negrunicusor/Square-Wave-Signal-Generator-SMT-PCB/Layout/layout.jpg

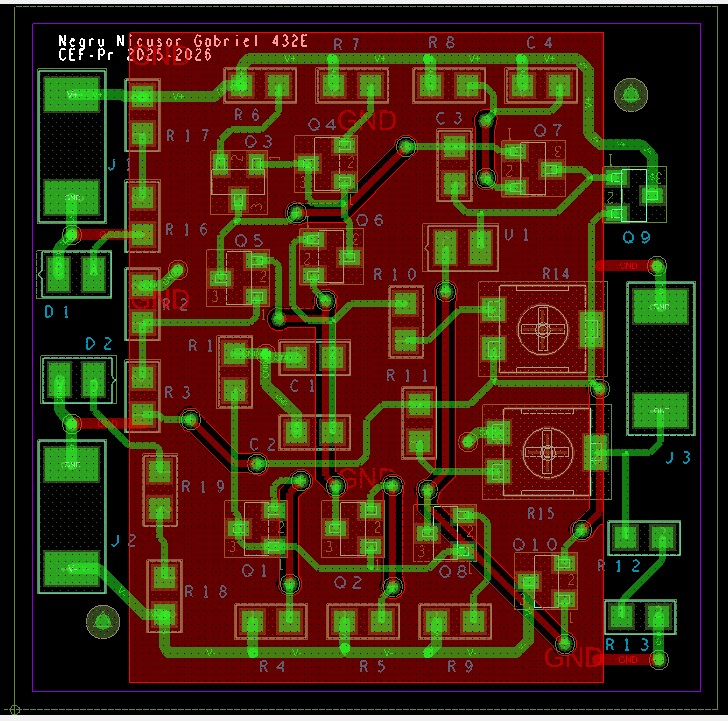
Layout/layout.jpg
