negrunicusor/Square-Wave-Signal-Generator-SMT-PCB/Project_Presentation.pdf

## Circuite Electronice Fundamentale 2 – Proiect (CEF2-Pr)

Student: Negru Nicusor Gabriel Grupa 432E

## Tema: Generator de semnal dreptunghiular

## Date de proiectare

Cerințe electrice:
- Frecvența de oscilație, f0, reglabilă în intervalul 32-64 KHz;
- Factor de umplere: 0.5;
- Sarcina la ieșire, RL
: 16kΩ;
- Valoarea (vârf la vârf) a oscilației la ieșire, V0, reglabilă în intervalul 0-4V;
- Semnalul la ieșire nu are componentă continuă;
- Domeniul temperaturilor de funcționare: 0° - 70°C
- Semnalizarea prezenței tensiunilor de intrare/ieșire cu o diodă de tip LED

Cerințe tehnologice:
- Dimensiunile PCB: 40mm x 40mm;
- Material FR4, dublu strat;
- Originea (punctul de coordonate (0,0)) va fi plasat în colţul din stânga-jos al plăcii de cablaj imprimat)
- Dimensiuni trasee:
- Curent de 1A - 26 mil;
- Curent de sute de mA - 18 mil;
- Semnal - 16 mil;

## Schema bloc

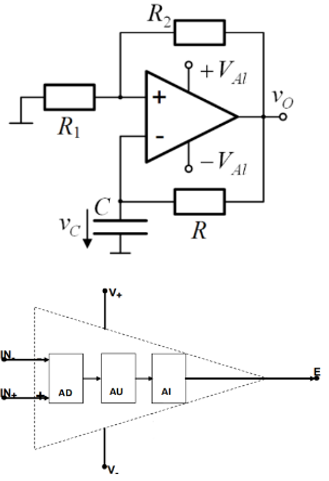
[picture p2: figure]

Oscilatorul de relaxare este constituit dintr-un comparator inversor cu histerezis și o rețea RC pe intrarea inversoare.

Intrarea neinversoare este conectată la un divizorul de tensiune, prin intermediul căruia de aplică o parte din semnalul de la ieșire și prin care se fixează tensiunile de prag de histerezis.

Gruparea RC, la care se adaugă un potențiometru, setează frecvența de oscilație.

Amplificatorul operațional este alcătuit din trei etaje de amplificare.

## Schema electrică

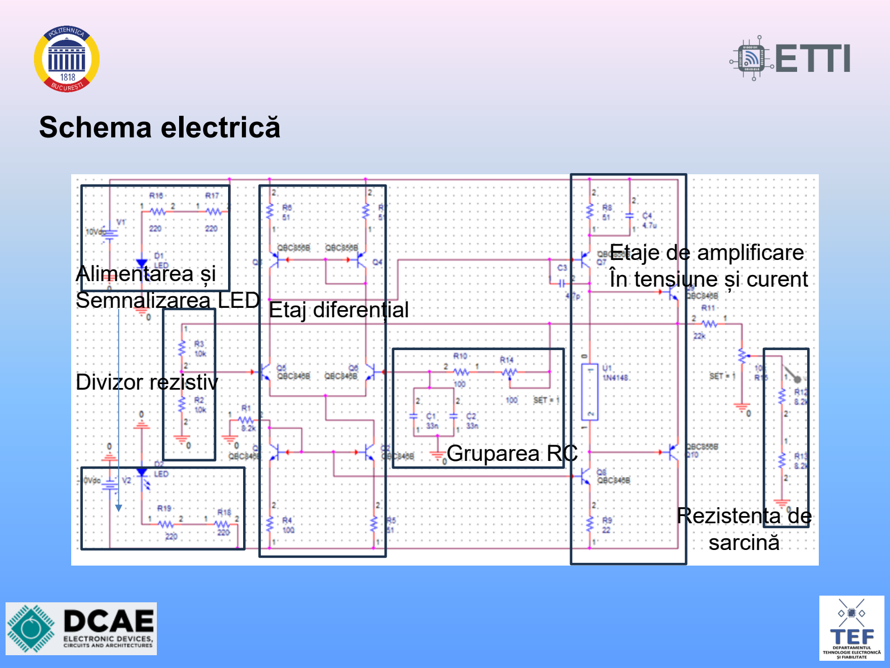
[picture p3: page 4]

Gruparea RC

Etaj diferențial

Divizor rezistiv

Rezistenta de
sarcină

Etaje de amplificare
Alimentarea și | În tensiune și curent
Semnalizarea LED

## Simulări

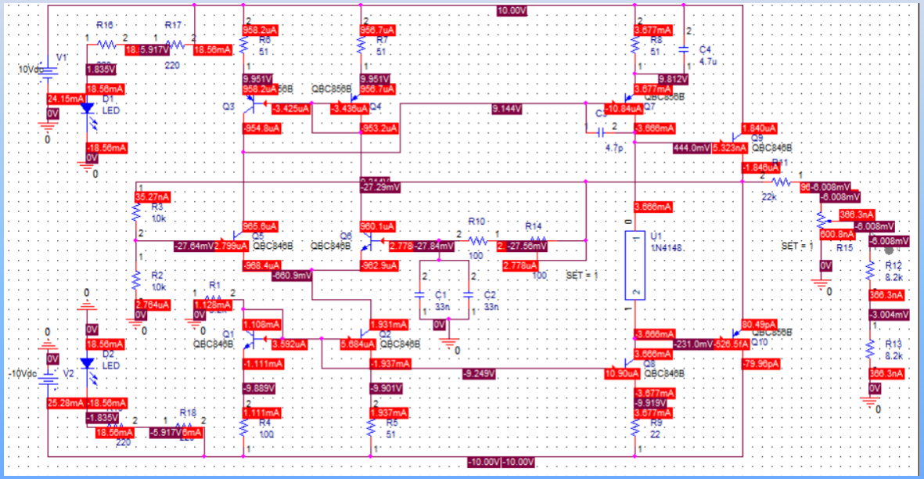
[picture p4: figure]

## Simulări

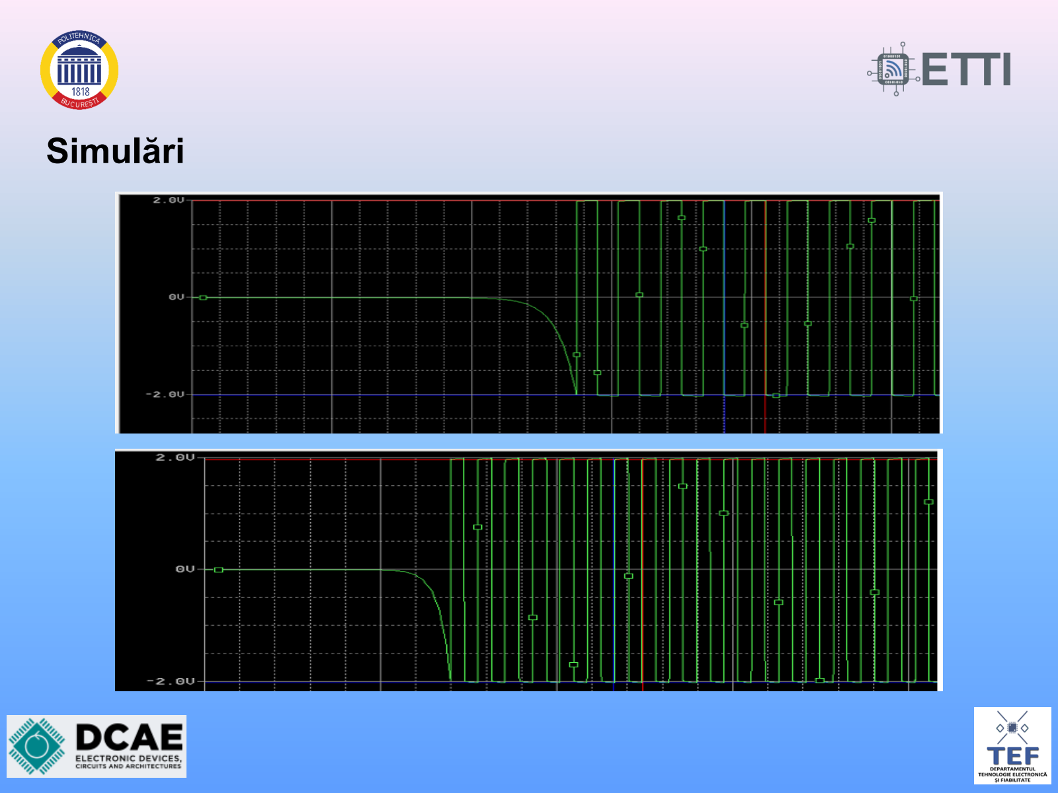
[picture p5: page 6]

## Layout

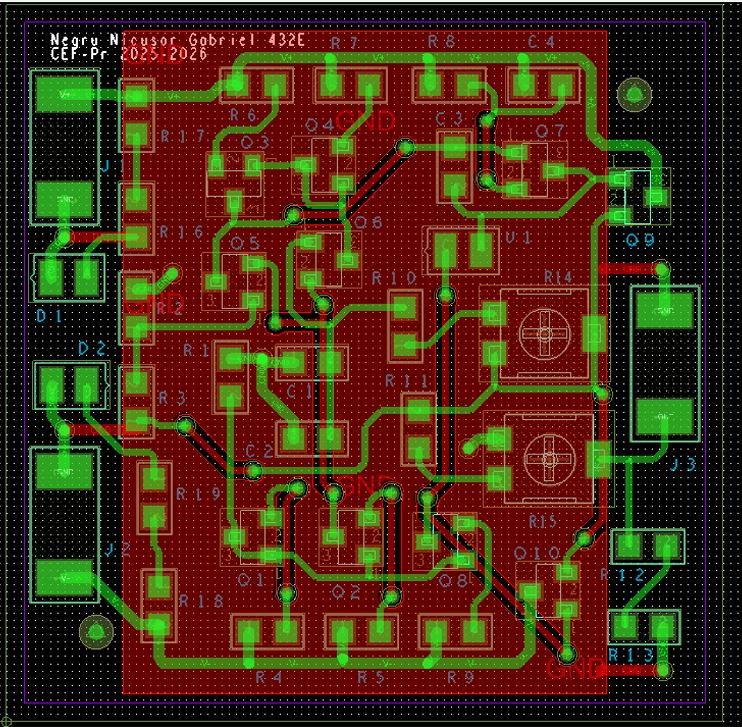
[picture p6: figure]

## Vedere Top

Poziționarea | componentelor | s-a
realizat | pe | baza | următoarelor
condiții:
- Componentele pasive au fost așezate spre exteriorul plăcii, iar cele active, în mijloc.
- Tranzistoarele au fost plasate cât mai apropiate pentru a concentra distribuția căldurii.

## Layout

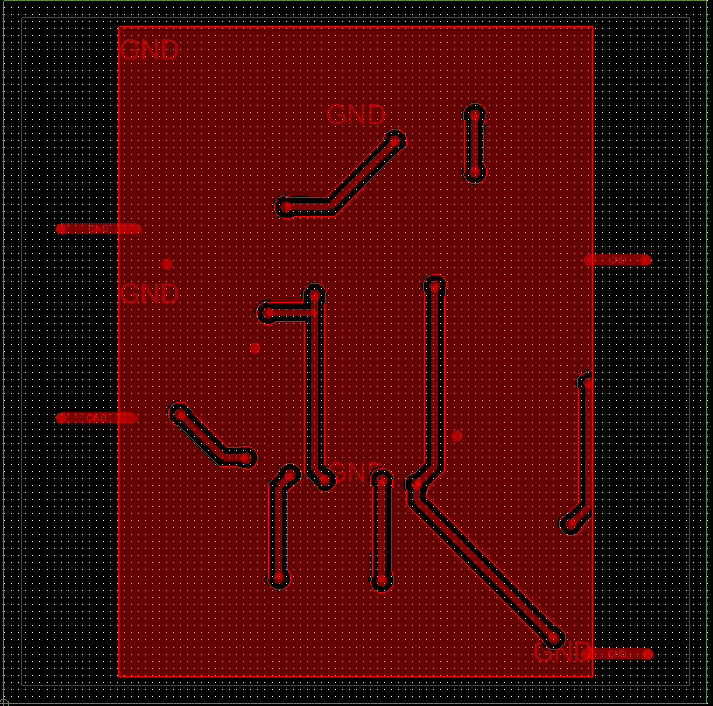
[picture p7: figure]

## Vedere Bottom

- Dimensiunile traseelor s-au setat în
concordanță | cu | cerințele | de
proiectare.

## Fotografii din etapa de echipare a modulului electronic

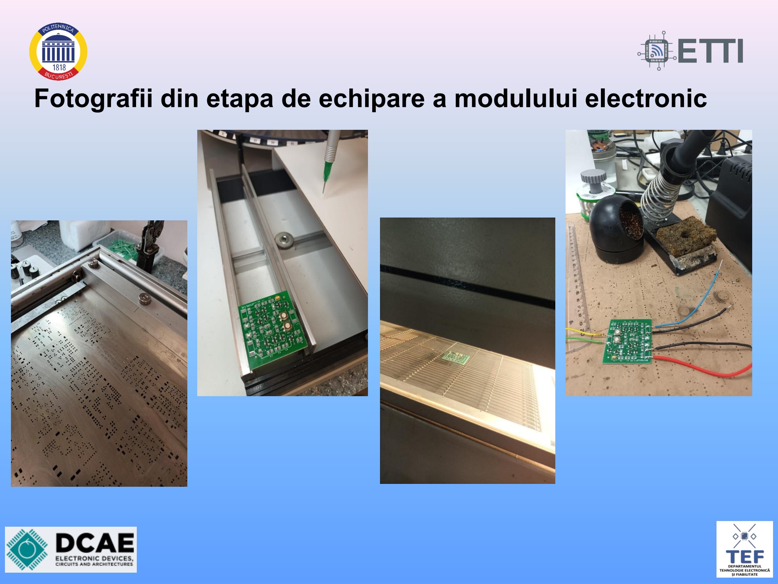
[picture p8: page 9]

## Rezultate experimentale

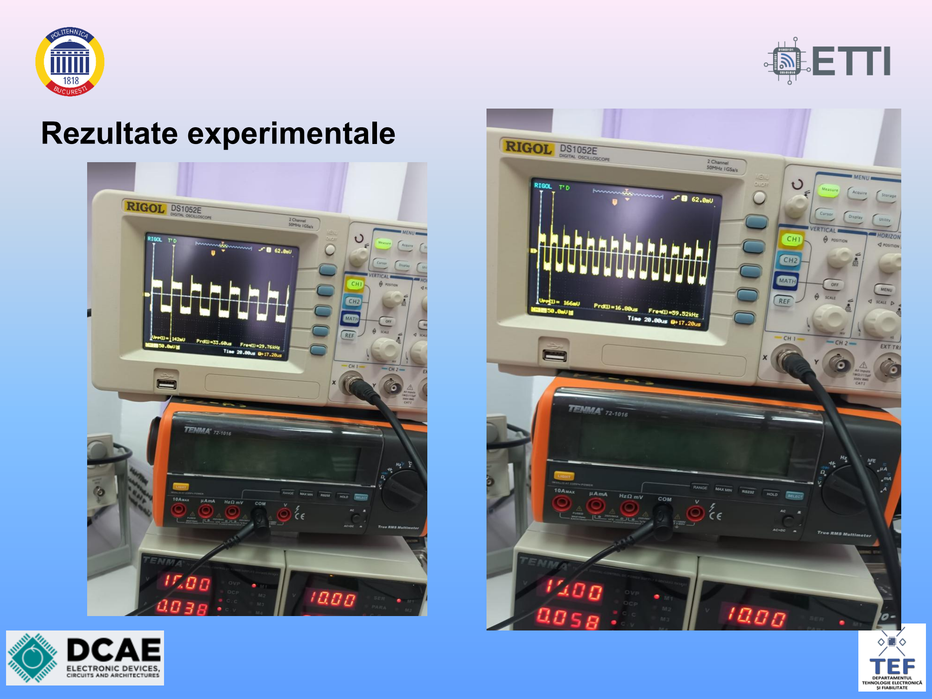
[picture p9: page 10]

## Rezultate experimentale

•Tabel comparativ

Cerințe impuse | Rezultate simulări | Rezultate măsurători
Fmin = 32 kHz | Fmin = 34,53 kHz | Fmin = 29,76 kHz
Fmax = 64 kHz | Fmax = 60,81 kHz | Fmax = 59,52 kHz
Vo,min = 0 Vpp | Vo,min = 570 nVpp | Vo,min aprox 0 Vpp
Vo,max = 4 Vpp | Vo,max = 3,98 Vpp | Vo,max aprox 160 mVpp
η = 0,5 | η = 0,51 | η = 0,49
Voffset = 0 Vpp | Voffset = 77,63 uVpp | Voffset = 36 uVpp

## Concluzii

Plan de depanare - organigrama

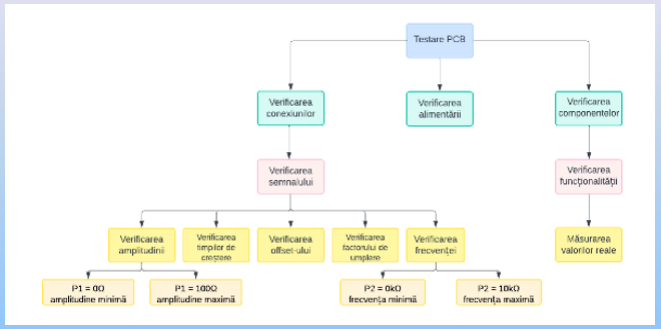
[picture p10: figure]

Din nefericire, din cauza neatentiei, potentiometrul responsabil de modificarea amplitudinii a fost montat de o valoare gresita, mult mai mica, ceea ce a dus la o cursa a amplitudinii in intervalul 0-160mVpp in loc de 0-4Vpp. In simulari am folosit un potentiometru de 10k, iar pe placa am montat un potentiometru de 100 de ohmi. Frecventa se incadreaza aproximativ in intervalul dorit, iar factorul de umplere si offsetul au mici deviatii.

## Concluzii

Cunostintele pe care le am dobandit pe parcursul acestui proiect sunt: calcularea unor parametri dupa specificatii bine precizate, aprofundarea mediului de lucru OrCad, invatarea si intelegerea unor tehnici avansate de proiectare si rutare etc

Partea buna in cadrul acestui proiect este faptul ca serveste ca un bun antrenament in cadrul practicii de vara pentru pasionatii ce aleg sa lucreze in acest domeniu. De asemenea, ajuta mult la intelegerea si insusirea unor cunostinte dobandite anterior la alte cursuri.

Nu am obiectii asuprea modului cum s-a desfasurat activitatea.

## Discipline studiate utile în realizarea proiectului

- Disciplinele din care au fost utilizate cunoștințe/informații pentru realizarea proiectului
1. Dispozitive Electronice
2. Circuite Integrate Analogice
3. Circuite Electronice Fundamentale
4. Tehnici CAD în realizarea modulelor electronice
- Ce discipline, aflate în semestrele din amonte, ar fi trebuit să fie mai bine însușite pentru ușurarea realizării activităților conexe proiectului?
1. Circuite Electronice Fundamentale
2. Circuite Integrate Analogice
