negrunicusor/Square-Wave-Signal-Generator-SMT-PCB/Proiect docs/Documentatie.pdf

# Circuite electronice fundamentale 2 – Proiect Generator de semnal dreptunghiular

Nume: Negru Nicușor Gabriel (N=16) Grupa: 432E

Cuprins

1.Date inițiale de proiectare

1.1.Tema proiectului

Să se proiecteze și realizeze un generator de semnal dreptunghiular cu următoarele caracteristici:
-frecvența de oscilație, f0, reglabilă în intervalul 32-64 kHz
-factor de umplere 0.5
-sarcina de ieșire, RL, 16k
-valoarea (vârf la vârf) a oscilației la ieșire, Vo, reglabilă în intervalul 0-4 V -semnalul la ieșire nu are componentă continuă
-domeniul temperaturilor de funcționare 0 ̊C-70 ̊C (verificabil prin testare în temperatură)
-semnalizarea prezenței tensiunilor de intrare/ieșire cu o diodă de tip led

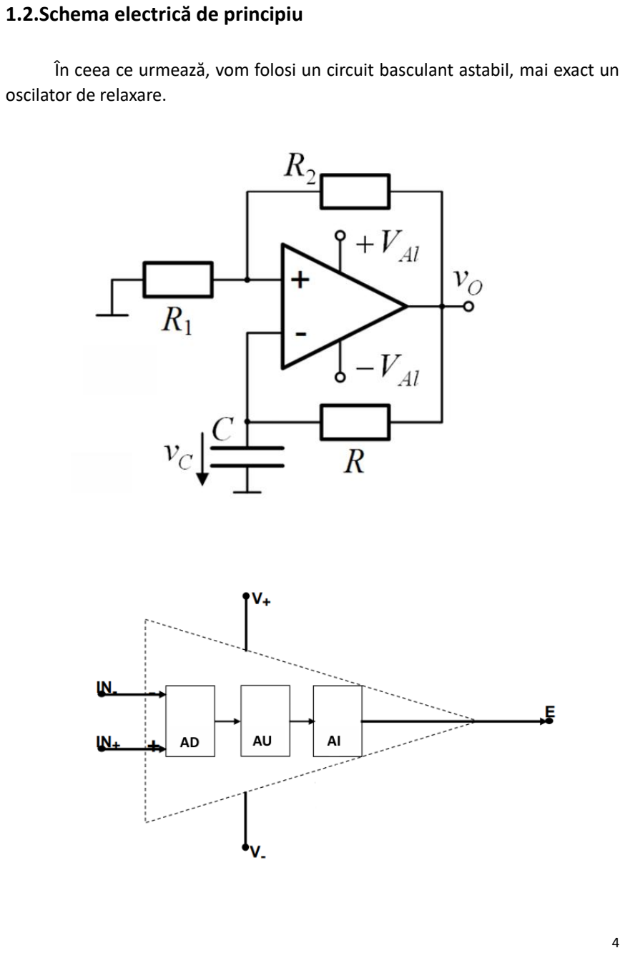
[picture p11: page 4]

1.2.Schema electrică de principiu

În ceea ce urmează, vom folosi un circuit basculant astabil, mai exact un oscilator de relaxare.

1.3.Schema electrică a montajului electric

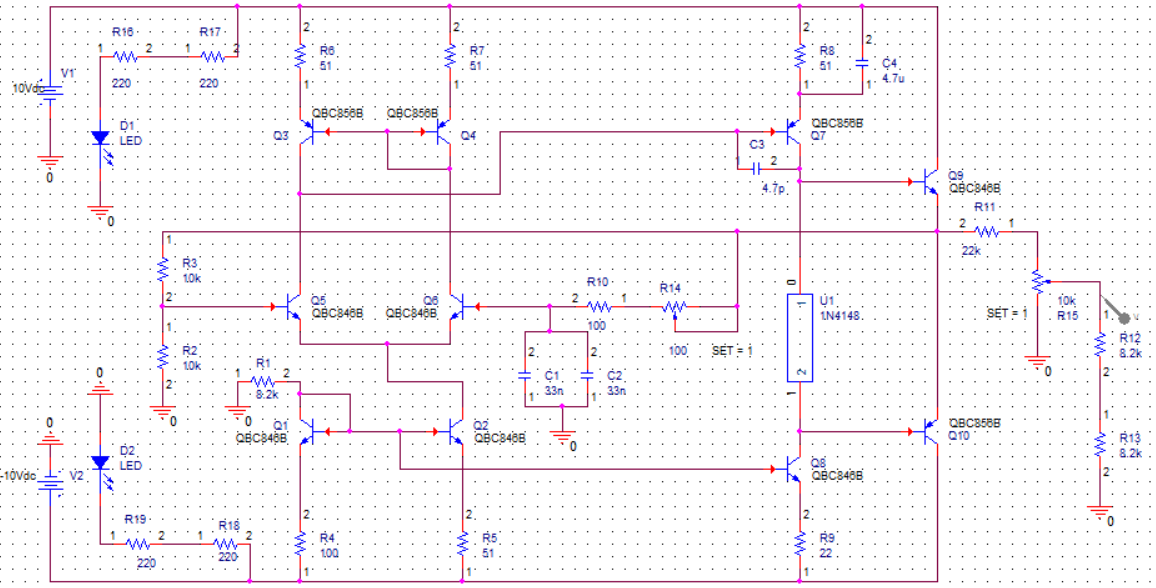
[picture p12: figure]

2.Conținutul tehnic/științific al proiectului

2.1.Descrierea funcțională a circuitului

Am construit un oscilator de relaxare dintr-un comparator cu histerezis și o rețea RC pe intrarea inversoare.

Intrarea neinversoare este conectată la divizorul de tensiune format din R2 și R3 prin intermediul căruia o parte din semnalul de la ieșire revine la intrare și cu ajutorul căruia, în același timp, se fixează tensiunile de prag de histerezis.

Gruparea formată din C1, C2, R10 și R14 setează frecvența de oscilație.

Blocul de amplificare a fost proiectat ca o implementare discretă și respectă arhitectura standard a unui amplificator operațional, fiind format din trei etaje:
-etajul de amplificare diferențială
-etajul de amplificare în tensiune
-etajul de amplificare în curent

Am folosit două surse de ±10V.

2.1.1.Etajul diferențial

Acesta este etajul de intrare al amplificatorului operațional discret. Rolul său este de a compara două tensiuni și de a amplifica diferența dintre ele. Este un amplificator diferențial cu sarcină activă, compus din trei părți distincte.

Tranzistoarele Q1 și Q2 formează o sursă de curent. Aceasta are rolul de a furniza curentul de polarizare pentru perechea diferențială și asigură o impedanță mare ce face etajul foarte imun la zgomot sau la variații ale tensiunii de alimentare. Rezistoarele R4 și R5 sunt rezistoare de degenerare de emitor și stabilizează sursa de curent la variațiile de temperatură.

Tranzistoarele Q5 și Q6 reprezintă perechea diferențială. Este de tip transconductanță, preia o diferență de tensiune la baze și o folosește pentru a dirija un curent între cele 2 colectoare. Baza lui Q5 reprezintă intrarea neinversoare, iar baza lui Q6
intrarea inversoare.

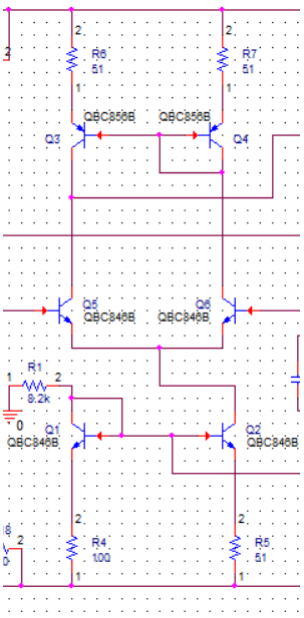
[picture p13: figure]

Tranzistoarele Q3 și Q4 alcătuiesc oglinda de curent ce acționează ca o sarcină activă cu impedanță foarte mare pentru a obține un câștig în tensiune uriaș.

2.1.2.Etajul de amplificare în tensiune

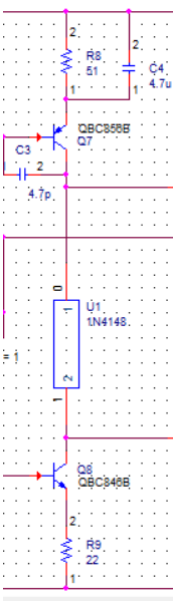
[picture p14: figure]

Acest bloc reprezintă etajul intermediar al circuitului, realizând interfața între comparatorul diferențial și buffer-ul de ieșire. Atât Q7, cât și Q8 funcționează în conexiunea emitor comun. Această configurație este aleasă specific pentru a oferi un câștig mare în tensiune. Rolul lor este de a prelua semnalul mic furnizat de etajul diferențial și de a-l amplifica până la o excursie de tensiune maximă, apropiată de valorile alimentării. Deoarece semnalul este dreptunghiular, aceste tranzistoare vor lucra preponderent în regim de comutație, asigurând fronturi abrupte semnalului.

Condensatorul C3, conectat între baza și colectorul lui Q7, realizează o reacție negativă locală dependentă de frecvență. Acesta are rolul crucial de asigurare a stabilității amplificatorului, prevenind auto-oscilațiile parazite de înaltă frecvență care ar putea apărea în timpul comutării rapide.

Rezistențele R8 și R9 sunt rezistențe de degenerare în emitor liniarizând funcționarea tranzistoarelor și stabilizând punctul static de funcționare împotriva variațiilor termice.

2.1.3.Etajul de amplificare în curent

Tranzistoarele Q9 și Q10 formează o configurație push-pull specifică amplificatoarelor de clasă B. Acesta este ultimul etaj al lanțului de amplificare și are rolul de a asigura puterea necesară transmiterii semnalului către sarcină, realizând totodată adaptarea de impedanță.
Este configurat ca un etaj colector comun, ceea ce însemnă câștig în tensiune x1, adică tensiunea de la ieșire este copiată de la intrare. În schimb, oferă un câștig mare în curent, esențial pentru a livra semnal
sarcinii.
Cele 2 tranzistoare funcționează complementar,

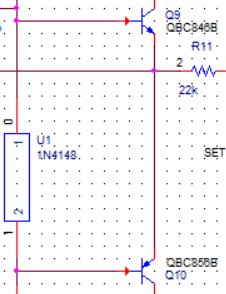
[picture p15: figure]

Q9 ocupându-se de alternanța pozitivă, iar Q10 de alternanța negativă. U1 asigură tensiunea bază-emitor pentru deschiderea celor două tranzistoare și mai are rol în reducerea distorsiunilor (crossoverului).

2.1.4.Alimentarea și ledurile

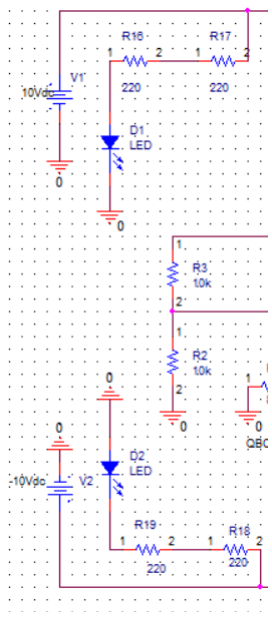
[picture p16: figure]

Circuitul este alimentat simetric cu ±10V. Astfel, semnalul de la ieșire nu are componentă continuă. Conform cerințelor de proiectare, am semnalizat tensiunile de la intrare cu leduri de tip KP-2012SRC-PRV, în serie cu 2 rezistențe pentru a limita curentul prin ele. Am folosit 2 rezistențe pentru a limita puterea disipată ce ar fi căzut pe una singură și ar fi distrus-o. Conform foii de catalog, ledul funcționează la o tensiune de 1,85V și la un curent de 20 de mA, iar valorile rezistențelor au fost alese în consecință.

2.2.Calculul de dimensionare

2.2.1.Frecvența de oscilație

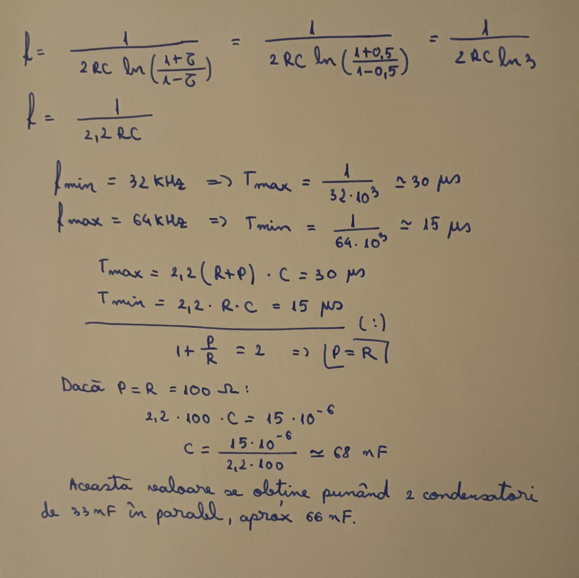
[picture p17: figure]

2.2.2.Tensiunea vârf la vârf

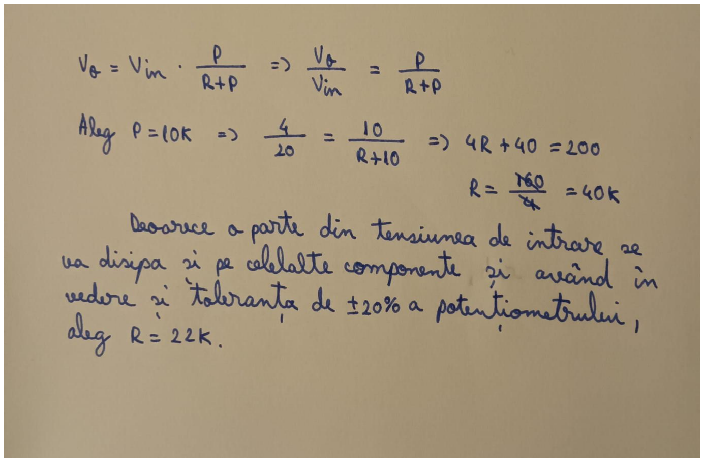
[picture p18: figure]

2.3.Punctul static de funcționare

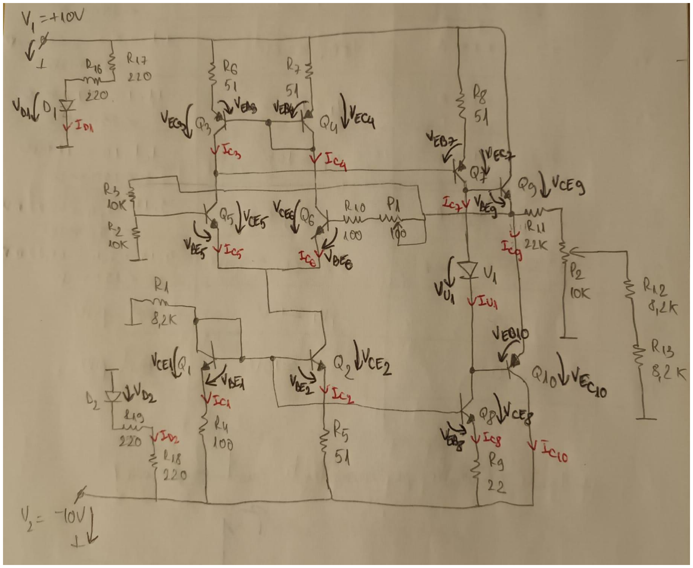
[picture p19: figure]
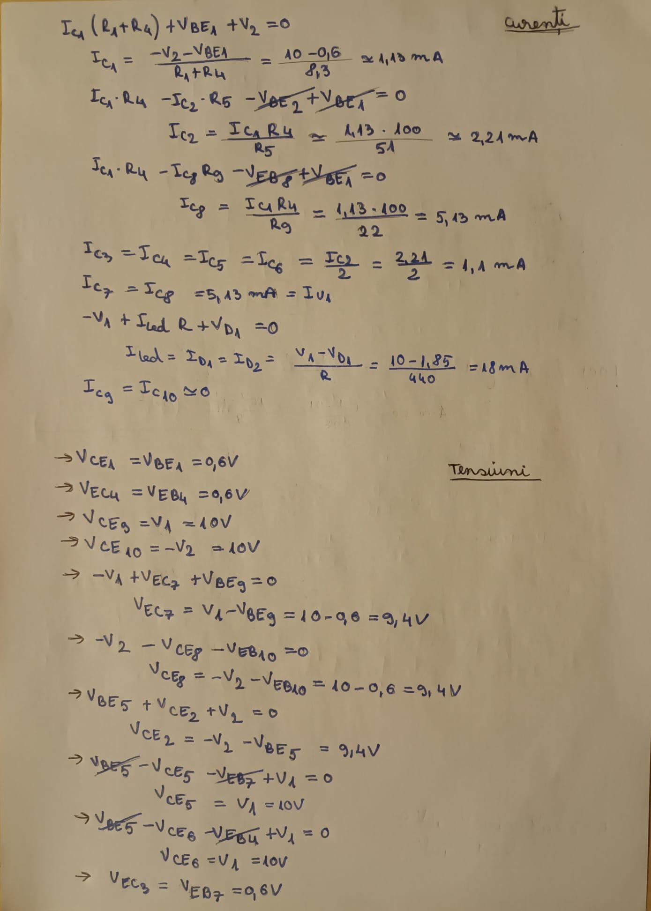
[picture p20: page 14]

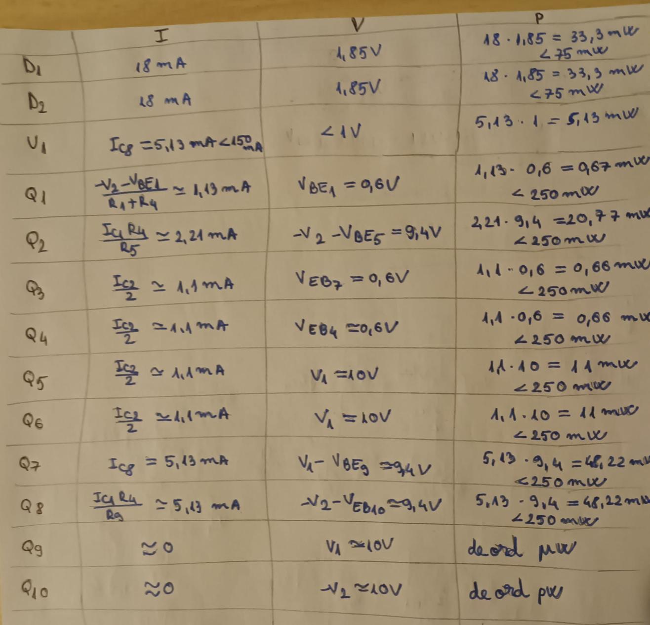
[picture p21: figure]

3.Simularea montajului electric

3.1.Curenți

Conform foilor de catalog al tuturor componentelor, ceea ce am obținut în simulare este sub limita curenților maximi.

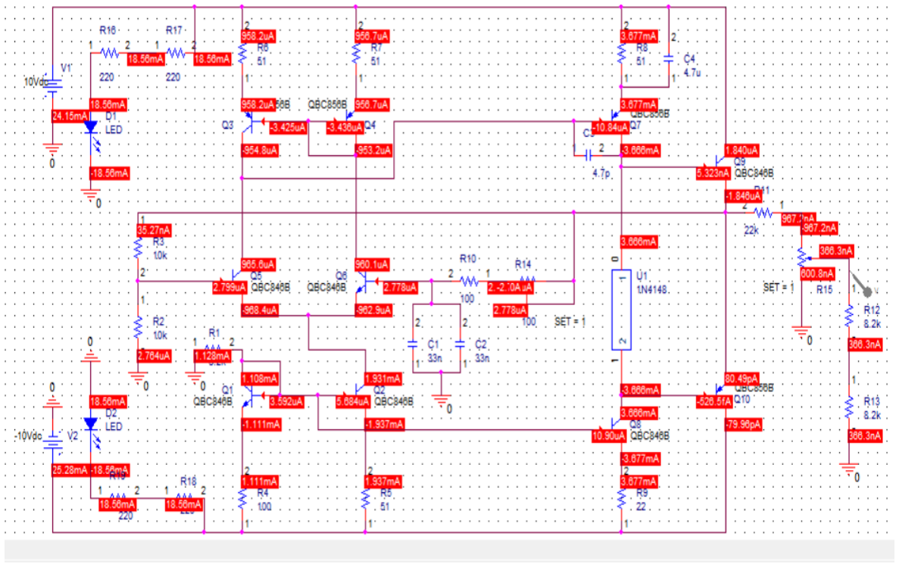
[picture p22: figure]

3.2.Tensiuni

Conform foilor de catalog al tuturor componentelor, ceea ce am obținut în simulare este sub limita tensiunilor maxime.

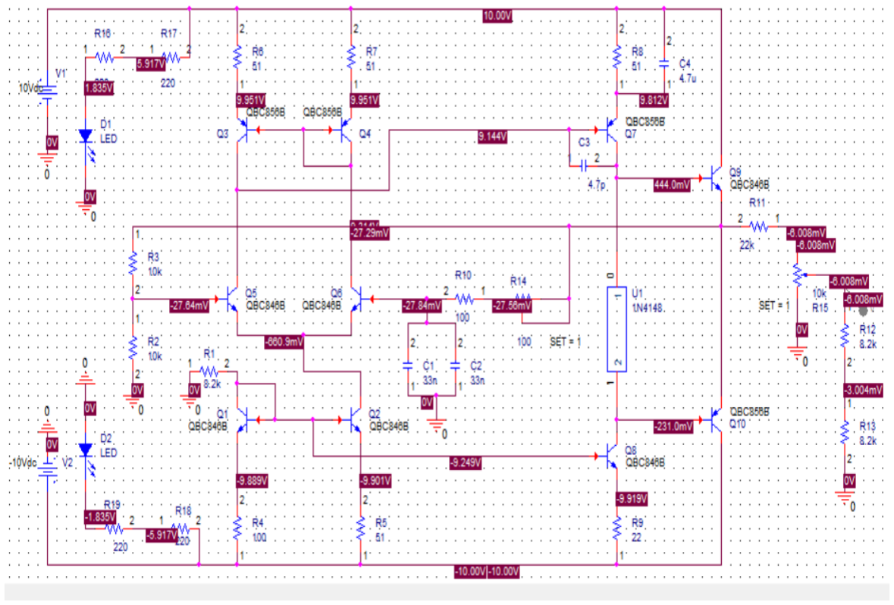
[picture p23: figure]

3.3.Puteri

Conform foilor de catalog al tuturor componentelor, ceea ce am obținut în simulare este sub limita puterilor maxime.

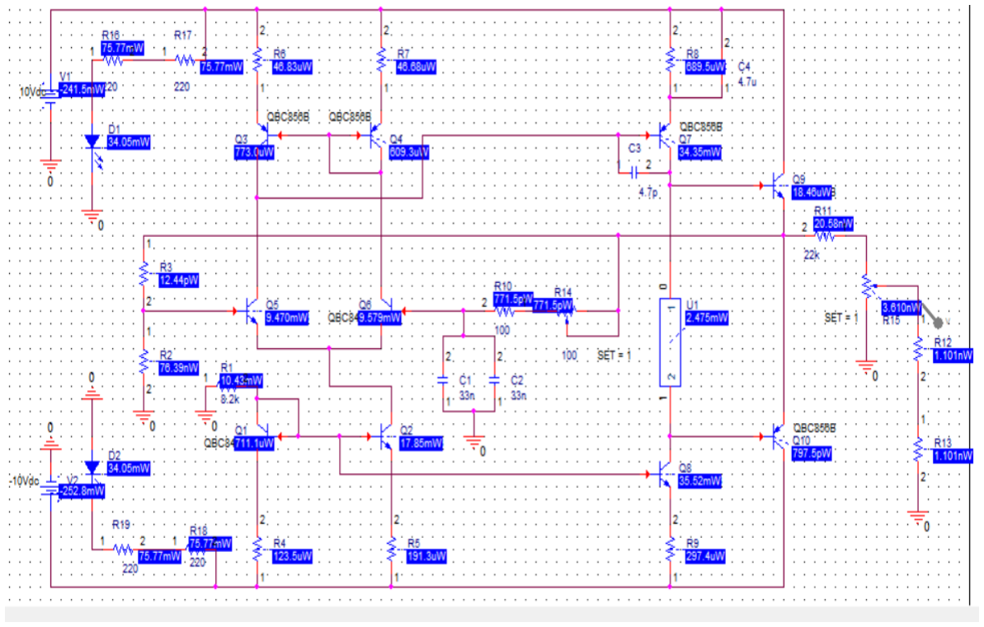
[picture p24: figure]
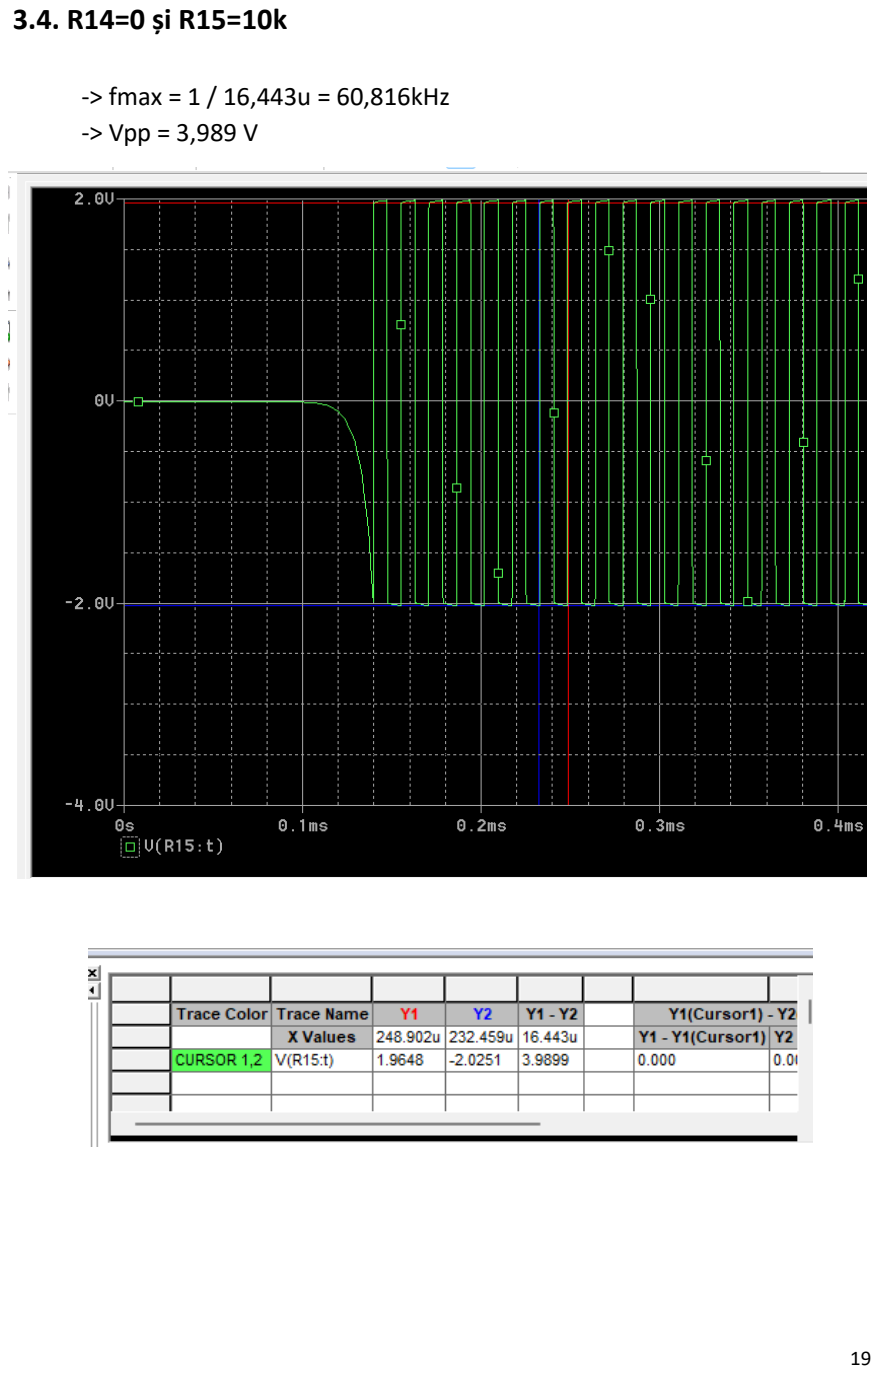
[picture p25: page 19]

### 3.4. R14=0 și R15=10k

-> fmax = 1 / 16,443u = 60,816kHz -> Vpp = 3,989 V

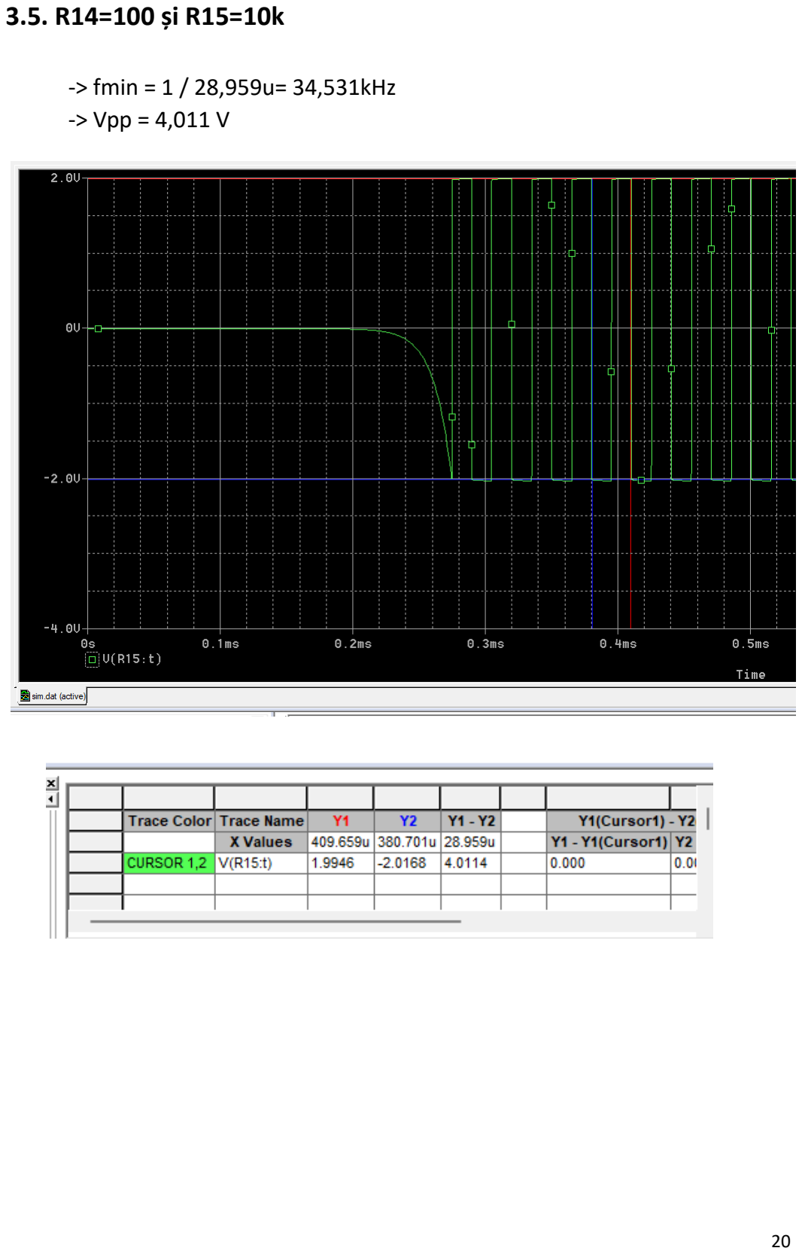
[picture p26: page 20]

### 3.5. R14=100 și R15=10k

-> fmin = 1 / 28,959u= 34,531kHz -> Vpp = 4,011 V

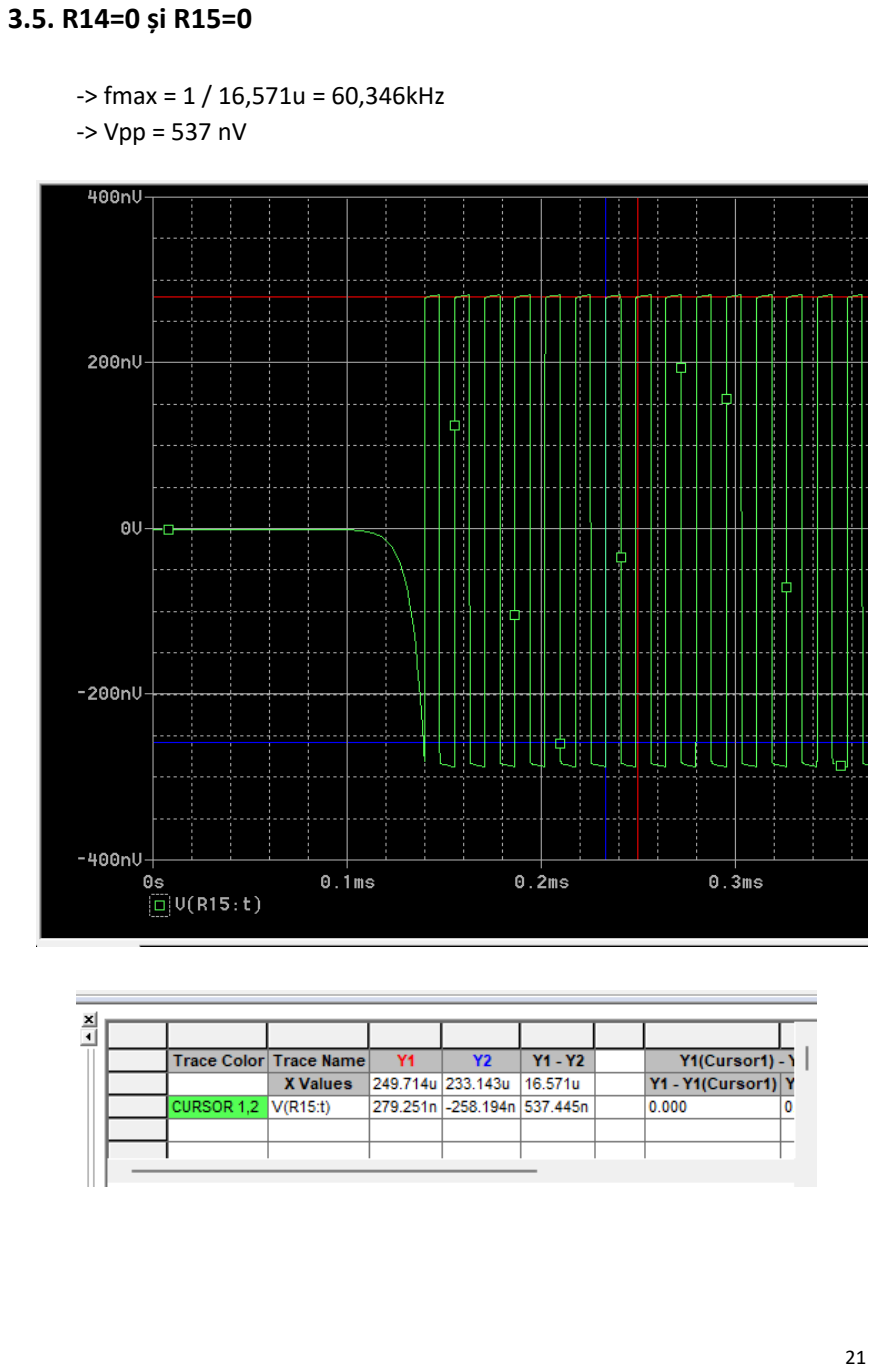
[picture p27: page 21]

### 3.5. R14=0 și R15=0

-> fmax = 1 / 16,571u = 60,346kHz -> Vpp = 537 nV

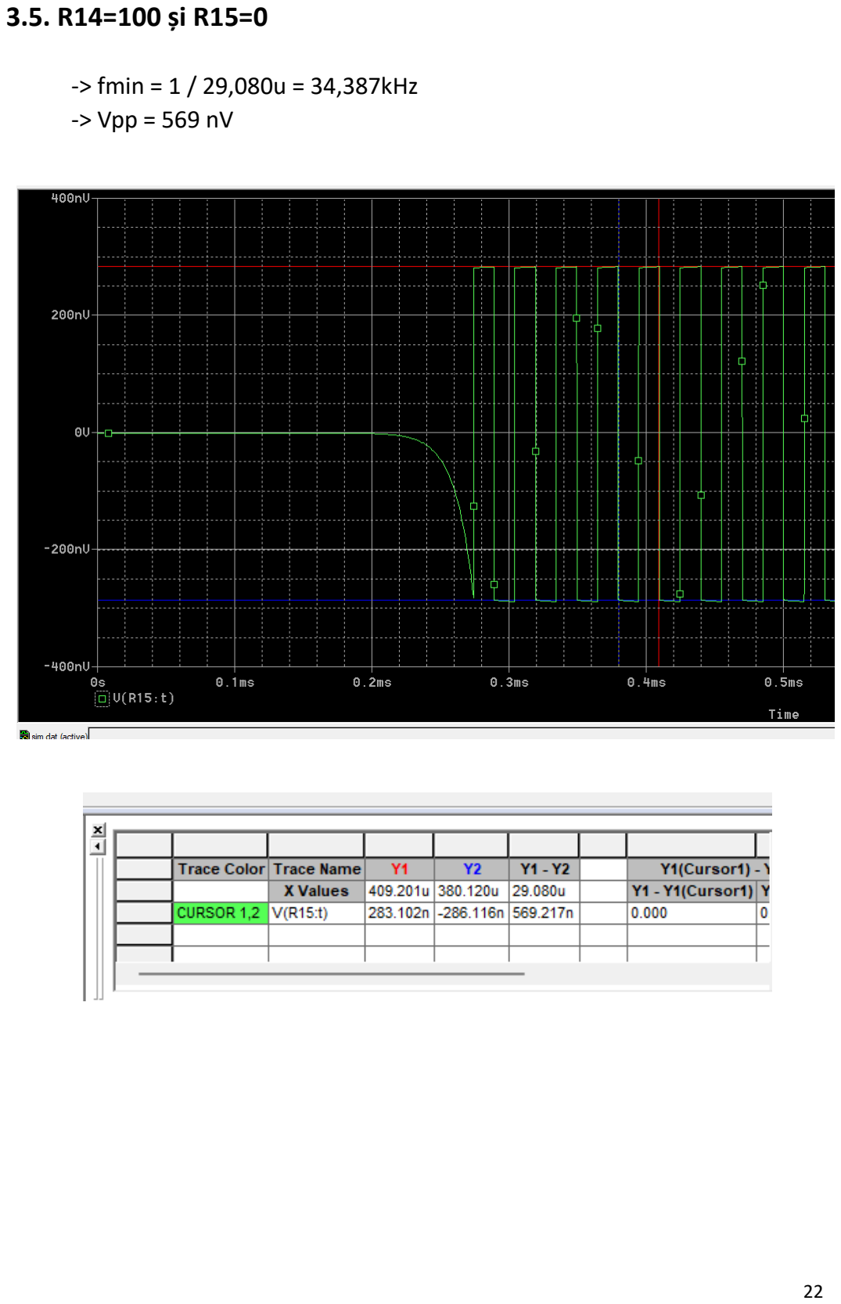
[picture p28: page 22]

### 3.5. R14=100 și R15=0

-> fmin = 1 / 29,080u = 34,387kHz -> Vpp = 569 nV

3.6.Temperatură

Am simulat funcționarea circuitului la temperaturile -20, 25, 120 grade Celsius, toate componentele funcționând normal în acest interval de temperatură.

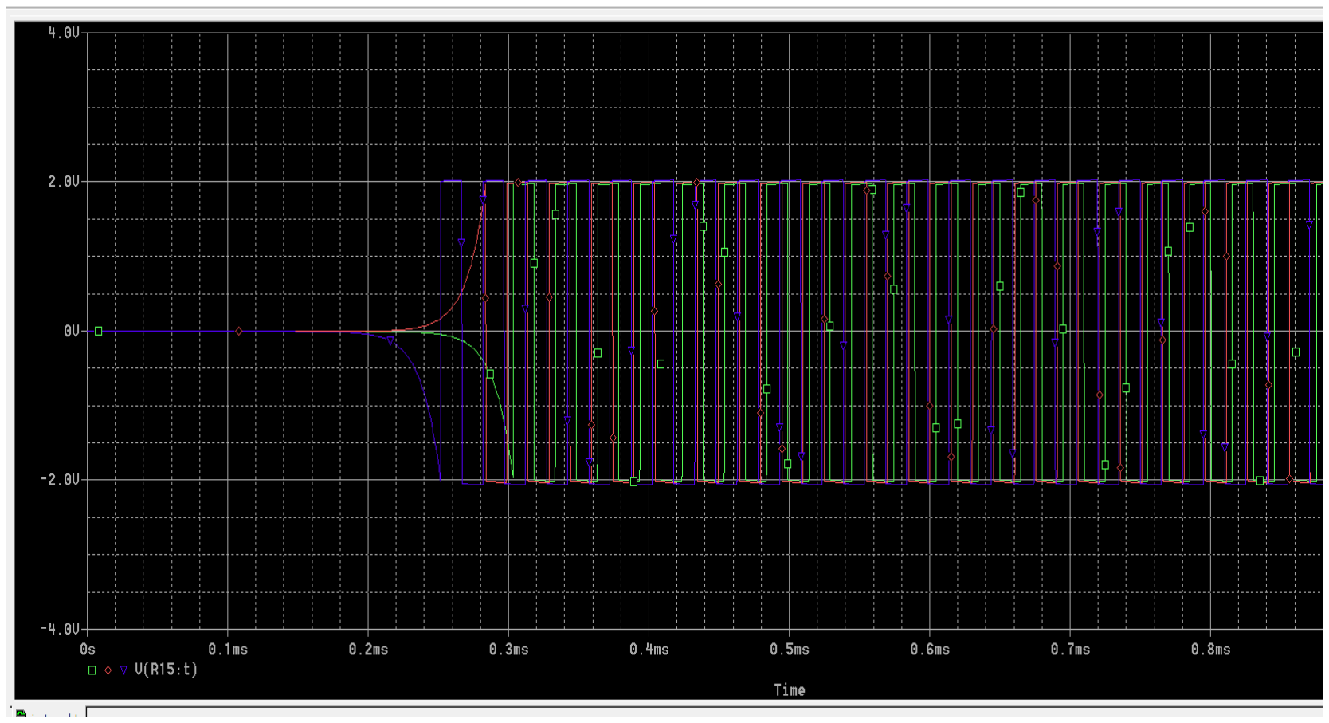
[picture p29: figure]

4.BOM

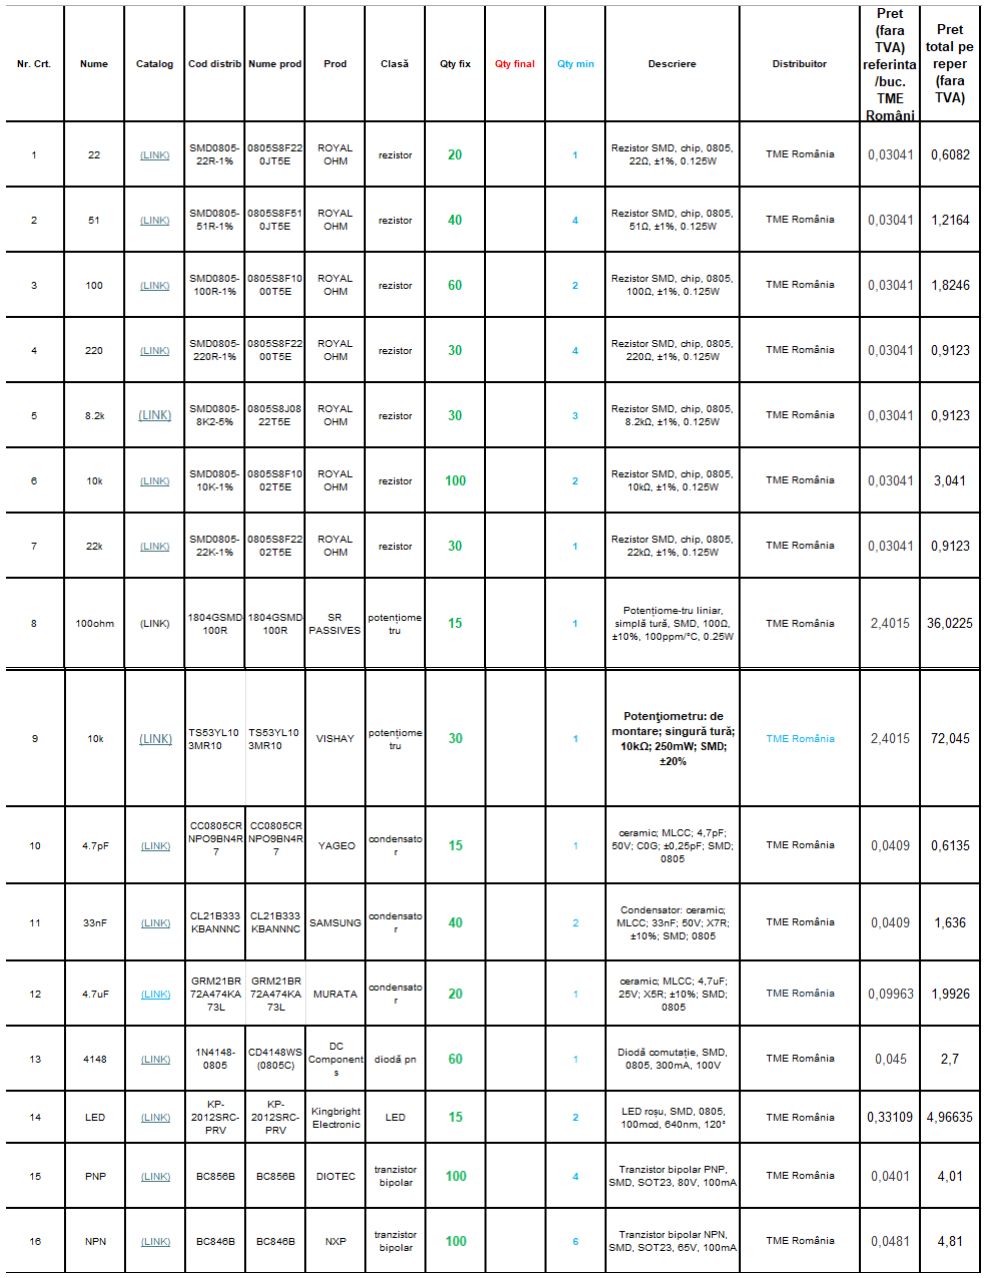
[picture p30: figure]

5.Layout

5.1.PCB design

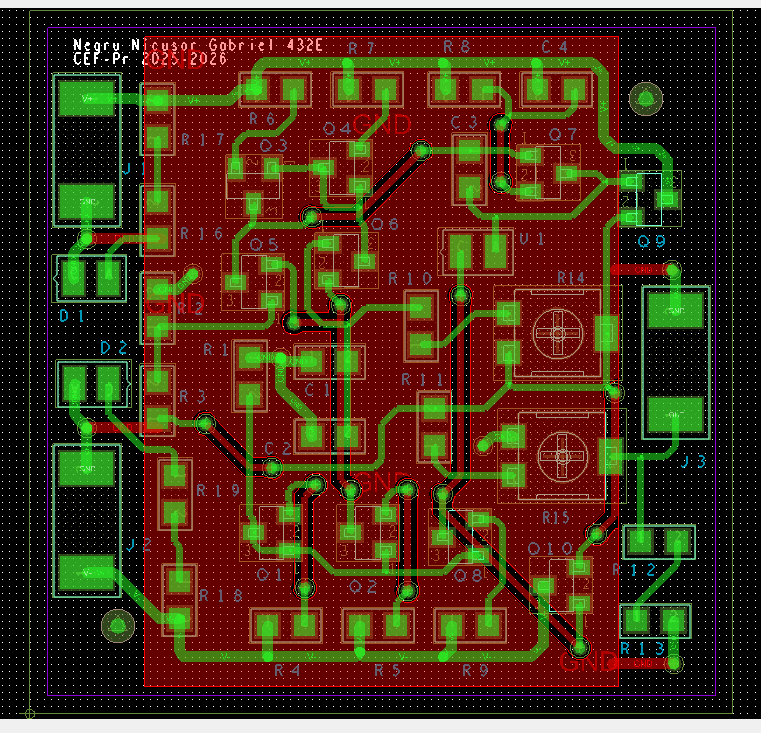
[picture p31: figure]

5.2.Layer electric TOP

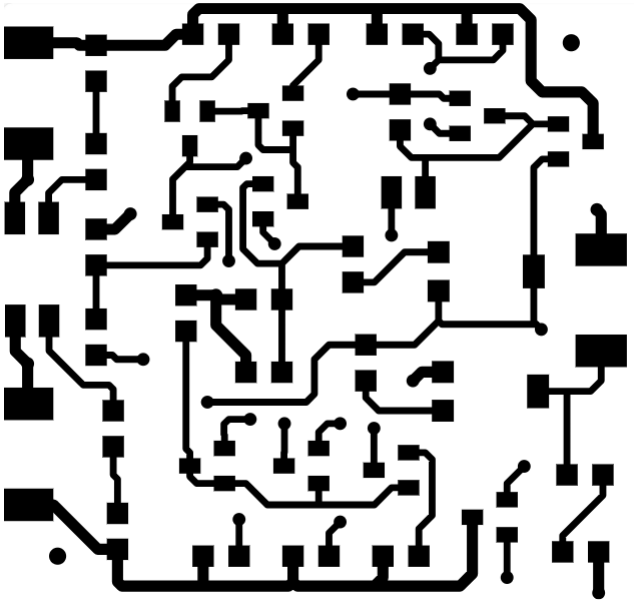
[picture p32: figure]

5.3.Layer electric BOTTOM

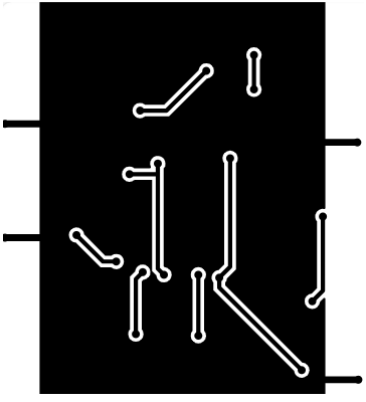
[picture p33: figure]

5.4.Solder Mask Top

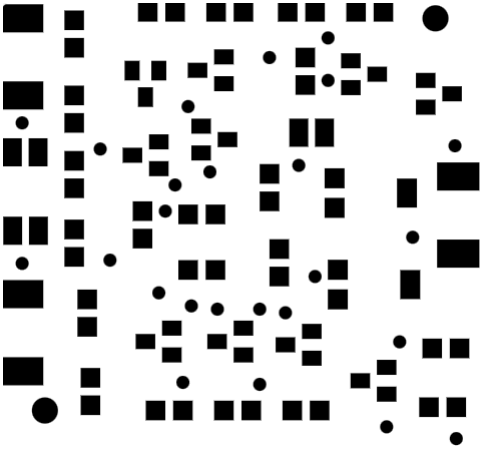
[picture p34: figure]

5.5.Solder Mask Bottom

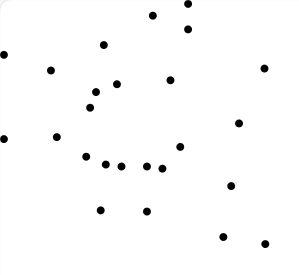
[picture p35: figure]

5.6.Silk Screen Top

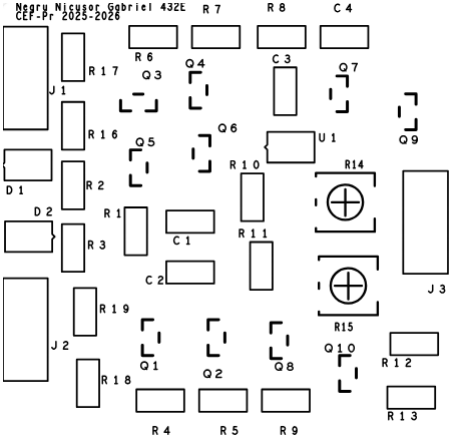
[picture p36: figure]

5.7.Paste Mask Top

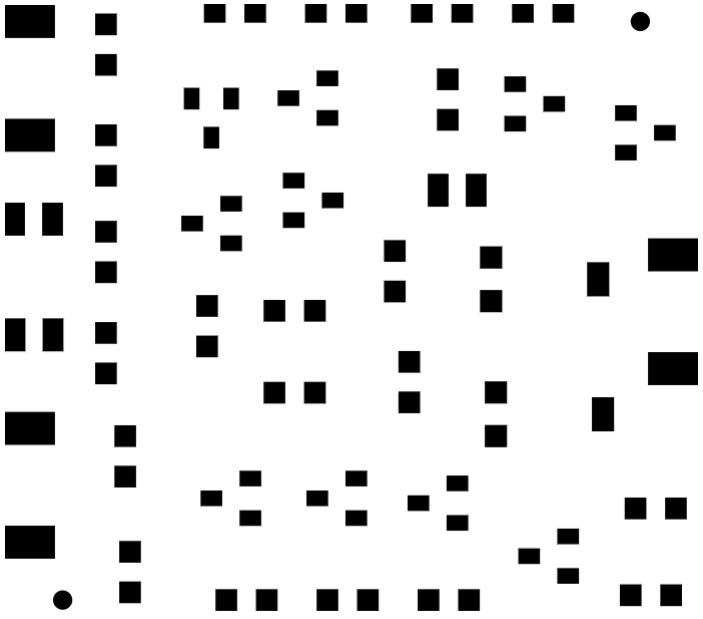
[picture p37: figure]

5.8.Board Outline

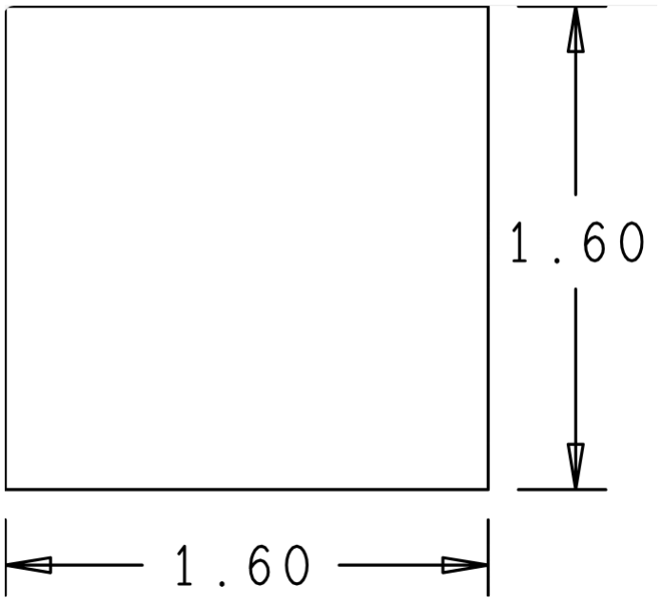
[picture p38: figure]

5.9.Fabrication Drawing

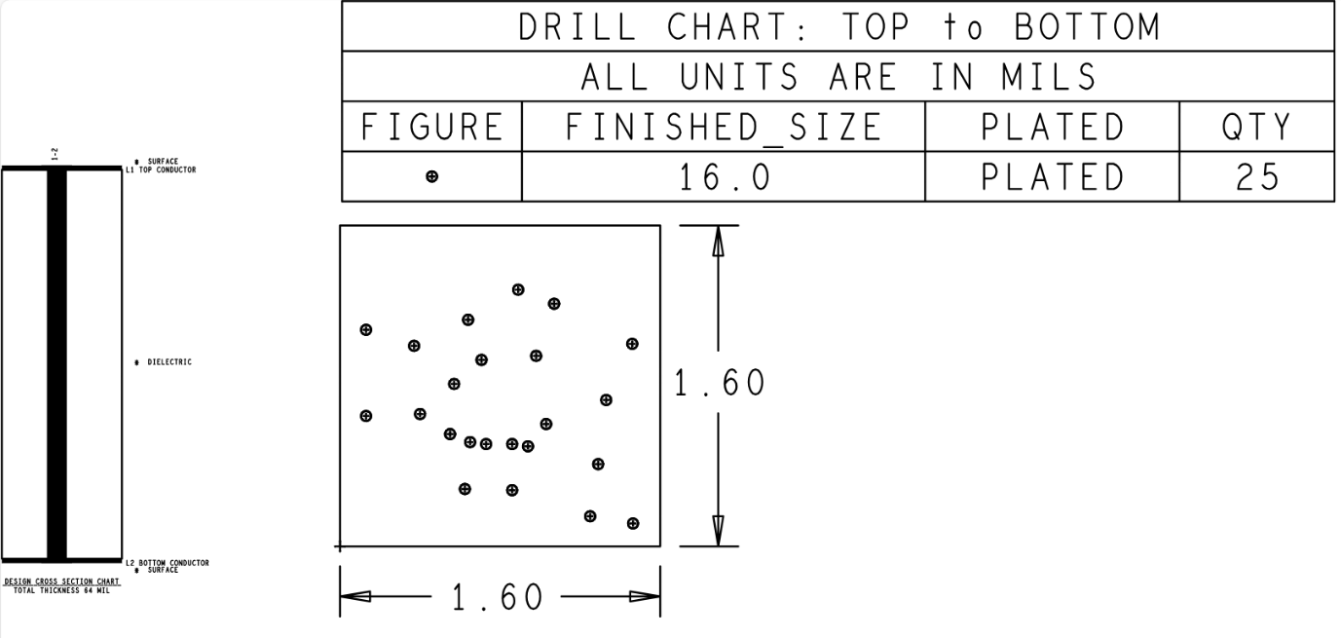
[picture p39: figure]
