negrunicusor/Square-Wave-Signal-Generator-SMT-PCB/schema_bloc.jpg

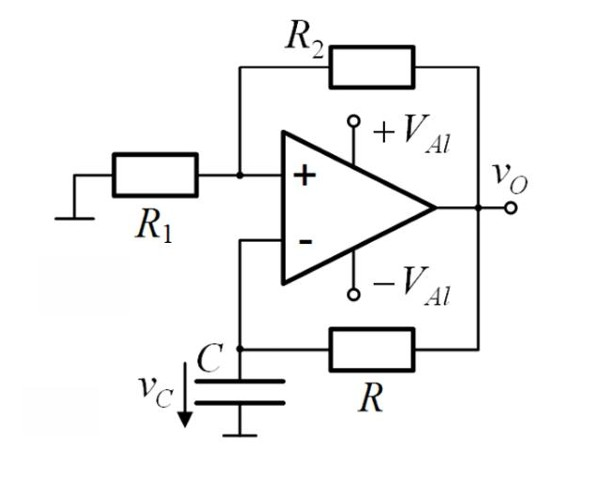
schema_bloc.jpg
