negrunicusor/Square-Wave-Signal-Generator-SMT-PCB/Schematics/schema_electrica.jpg

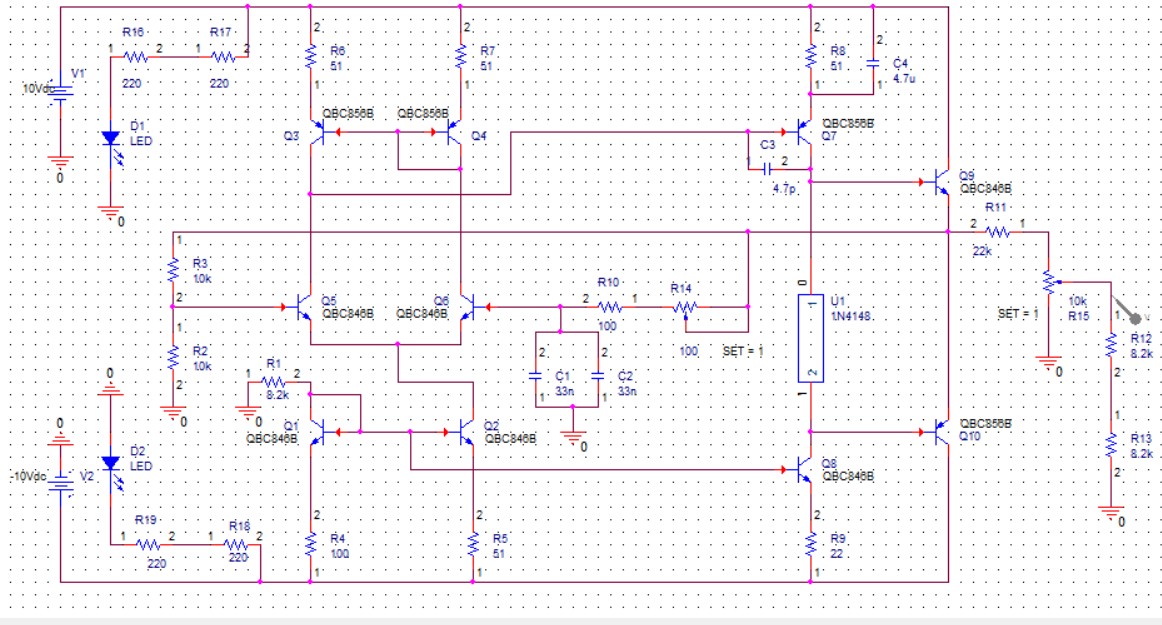
Schematics/schema_electrica.jpg
