negrunicusor/Square-Wave-Signal-Generator-SMT-PCB/Simulations/f max si Vpp max.jpg

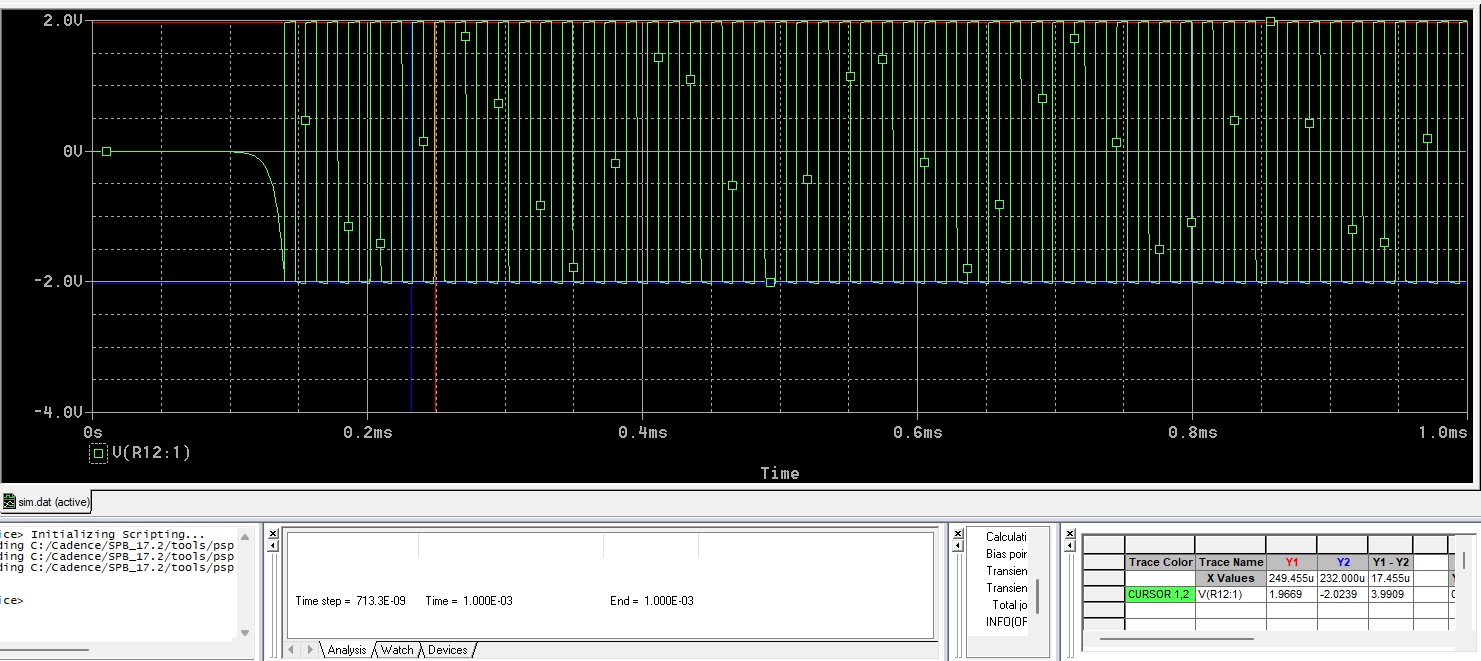
Simulations/f max si Vpp max.jpg
