negrunicusor/Square-Wave-Signal-Generator-SMT-PCB/Simulations/f max si Vpp min.jpg

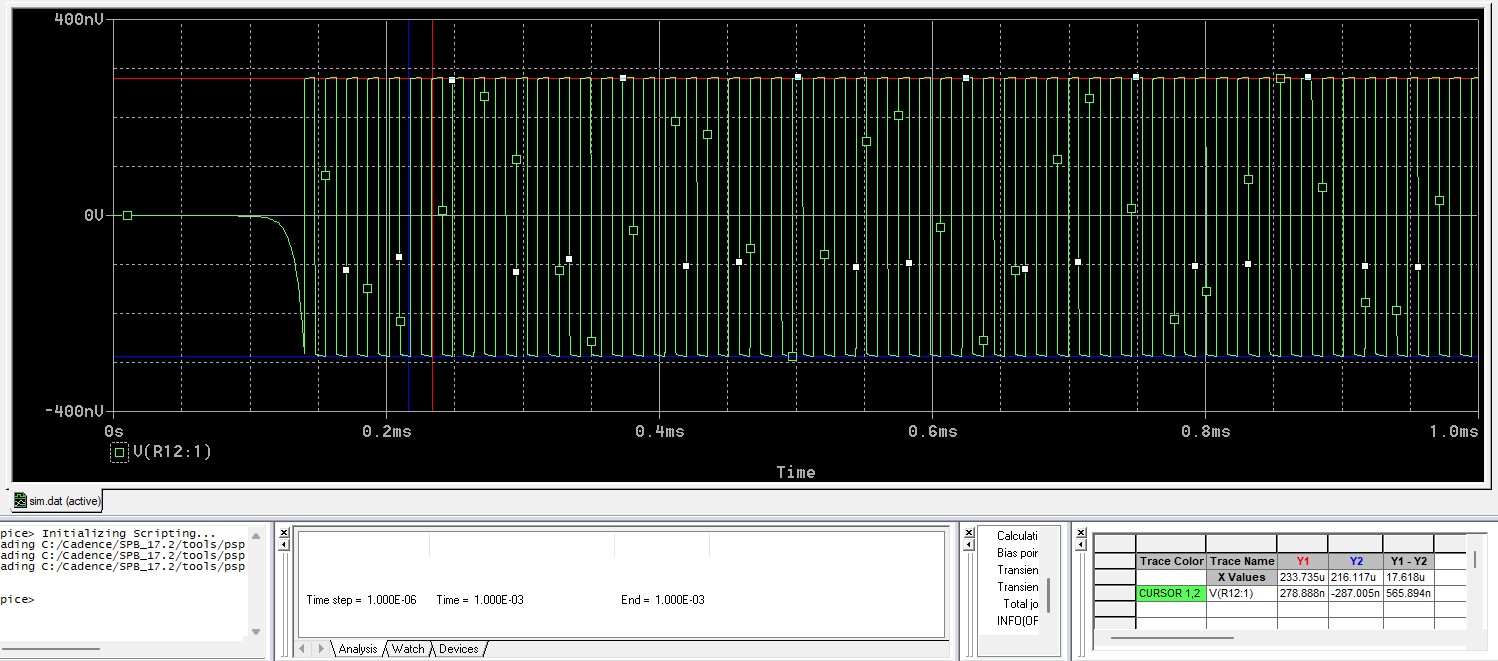
Simulations/f max si Vpp min.jpg
