negrunicusor/Square-Wave-Signal-Generator-SMT-PCB/Simulations/f min si Vpp max.jpg

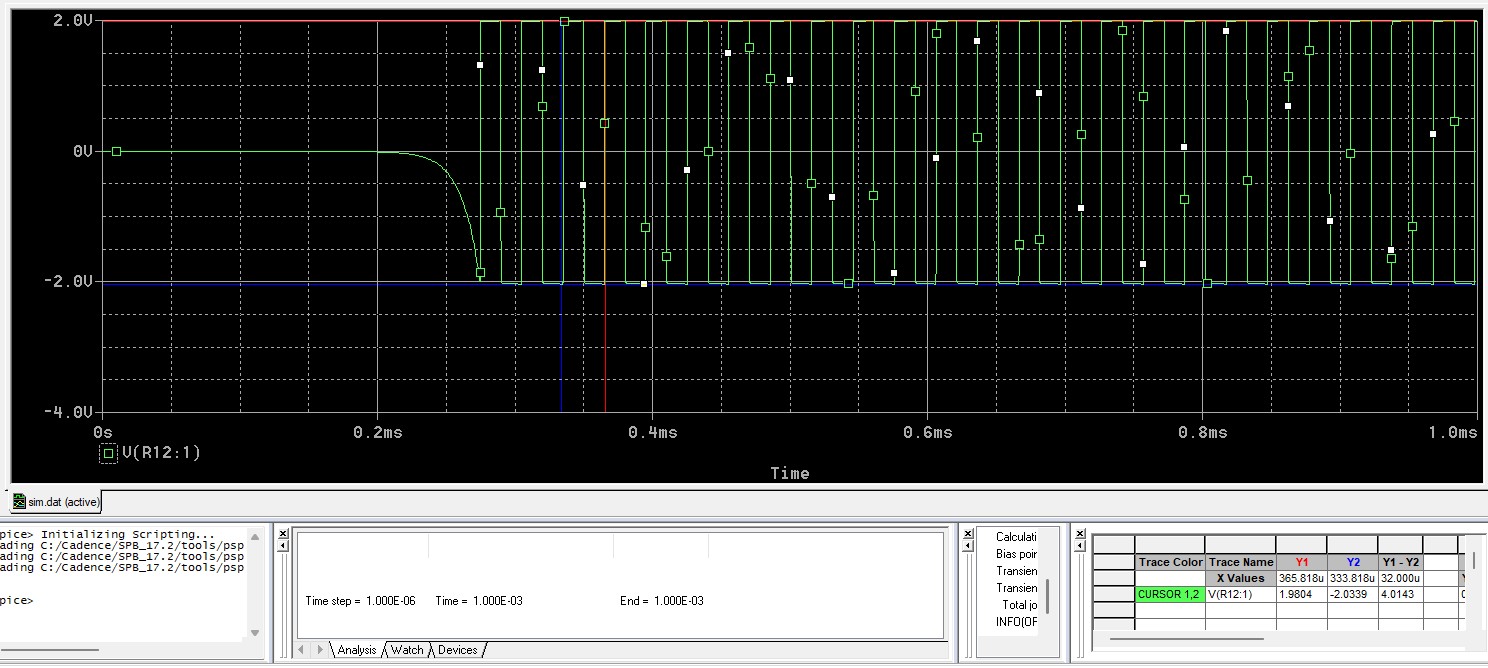
Simulations/f min si Vpp max.jpg
