negrunicusor/Square-Wave-Signal-Generator-SMT-PCB/Simulations/f min si Vpp min.jpg

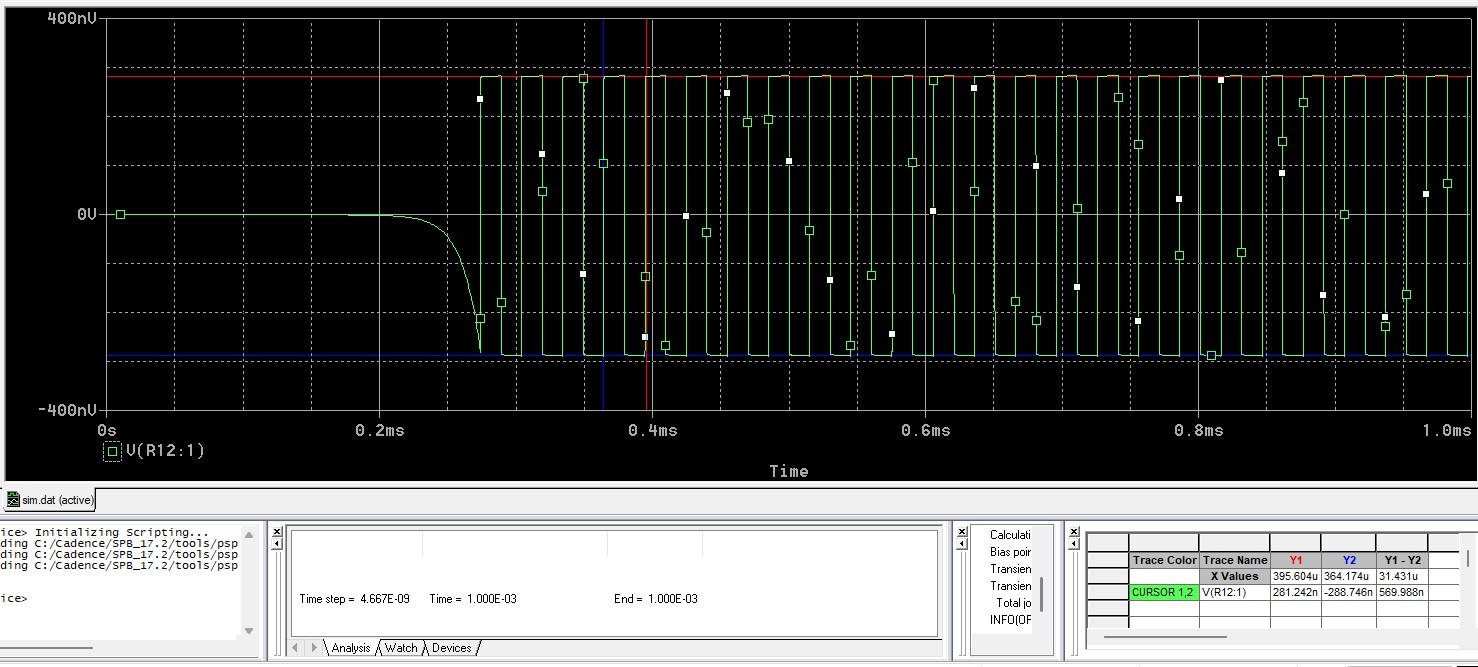
Simulations/f min si Vpp min.jpg
