negrunicusor/Square-Wave-Signal-Generator-SMT-PCB/Simulations/interval temperatura.jpg

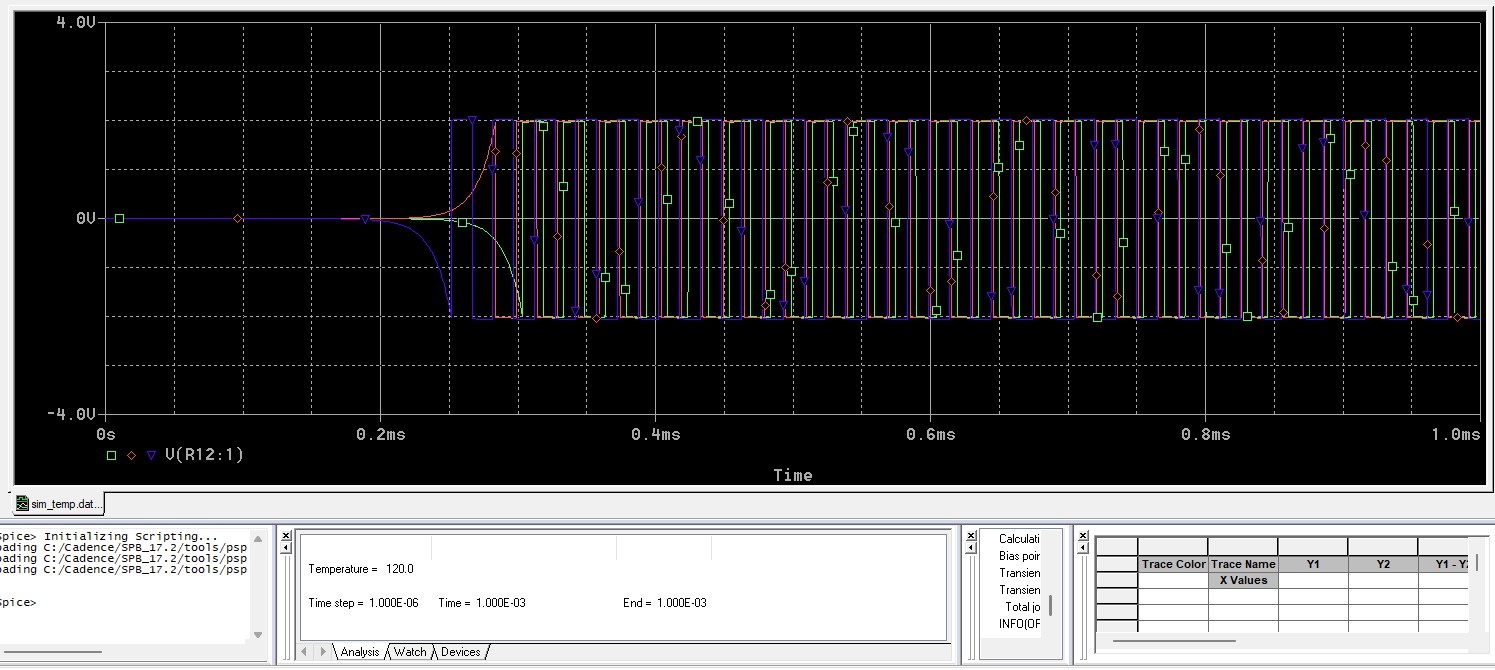
Simulations/interval temperatura.jpg
