negrunicusor/Square-Wave-Signal-Generator-SMT-PCB/(list of files, drawings)

Other design files:
Schematics/p1_v3.opj
Schematics/p1_v3_pcb.opj
