negrunicusor/Square-Wave-Signal-Generator-SMT-PCB/(commit log)

2026-02-17 Organizare foldere proiect
    [Anexa_a1_Grupa_432E_rev_1.xlsx, P1_V3_PCB.brd, p1_v3.opj, p1_v3_pcb.opj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]
2026-10-15 Update project presentation and OrCAD schematic
